royrobotiks/hoverboard_power_monitor/(commit log)

2021-02-24 Update README.md
    A little DC power monitor and data logger
2021-03-26 Corrected schematic Arduino to TFT KMR1.8
2021-03-26 Corrected the connection between KMR1.8 and Arduino
